1Picco/TV-Dynamic-Audio-Control-System/Schematic_TV-Dynamic-Audio-Control_2026-10-08.png

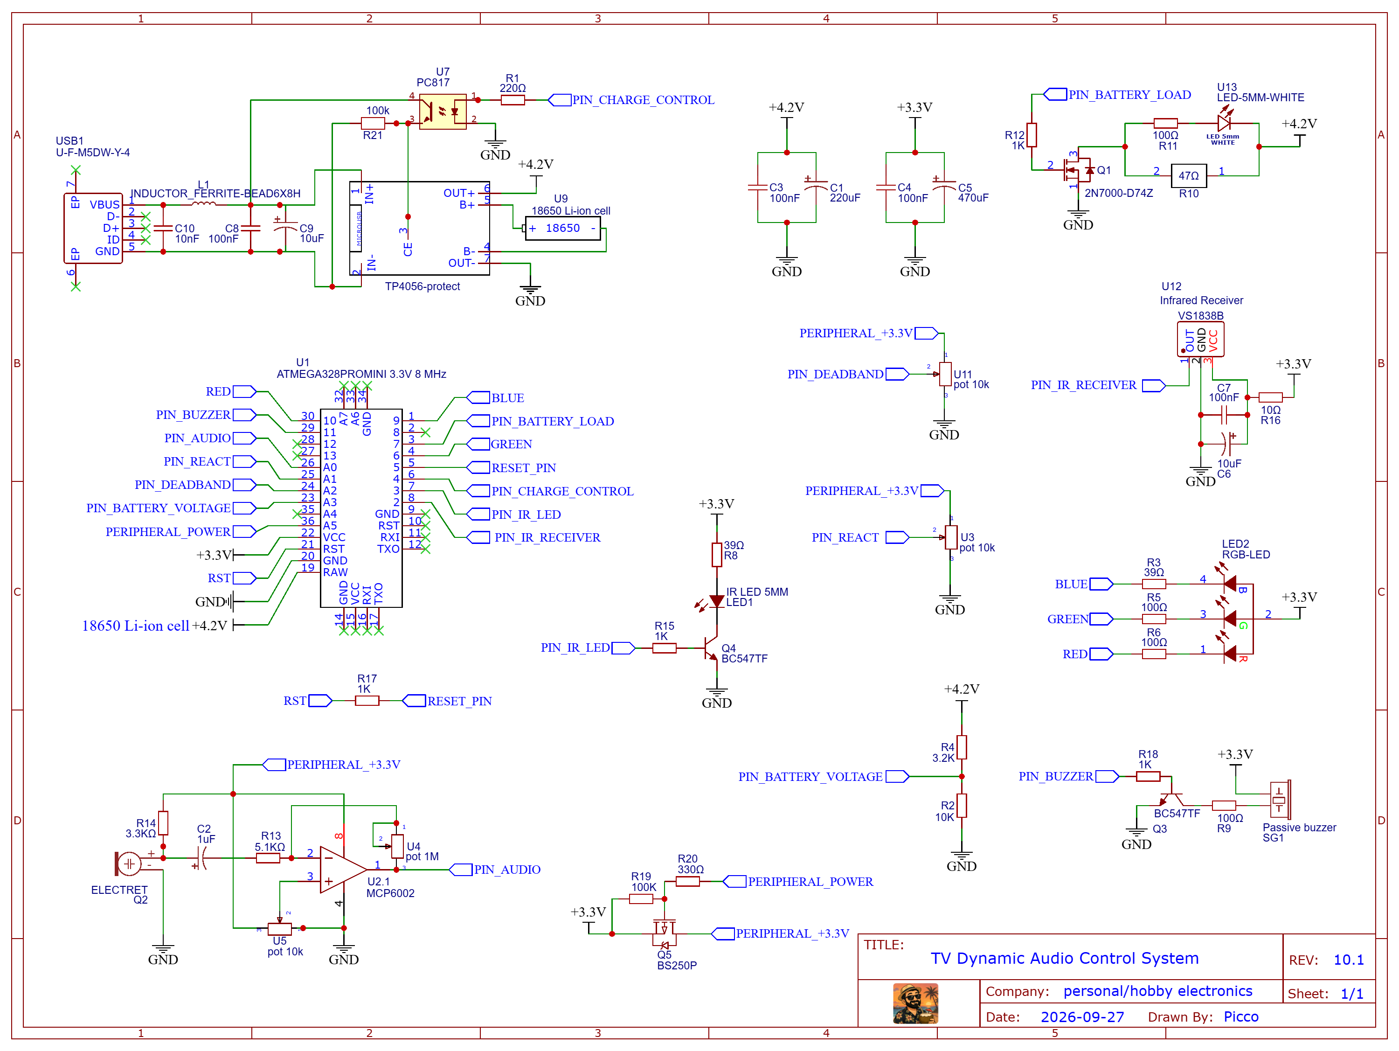
Schematic_TV-Dynamic-Audio-Control_2026-10-08.png
