1Picco/TV-Dynamic-Audio-Control-System/(list of files, drawings)

Other design files:
SCH_TV-Dynamic-Audio-Control_2026-10-04.json
