1Picco/TV-Dynamic-Audio-Control-System/Battery_Management.ino

// ============================================================================
// BATTERY MANAGEMENT FUNCTIONS
// ============================================================================

// VCC MEASUREMENT USING THE INTERNAL 1.1 V BANDGAP REFERENCE
// ============================================================================
// The ADC input is switched to the internal 1.1 V bandgap while AVcc is used
// as the ADC reference. Because ADC = Vbg / Vcc * 1023, the actual supply
// voltage is: Vcc(mV) = Vbg(mV) * 1023 / ADC.
//
// BANDGAP_CONSTANT = Vbg(mV) * 1023.
// Nominal: 1100 * 1023 = 1125300. The real bandgap of each chip can be
// anywhere between ~1.0 V and ~1.2 V. To calibrate, measure your real VCC
// with a multimeter and use: BANDGAP_CONSTANT = measured_VCC_mV * ADC_reading
// (the ADC reading of the bandgap, see the debug print below).

const uint32_t BANDGAP_CONSTANT = 1125600UL;

uint16_t RAW_BANDGAP = 0;   // raw ADC reading of the 1.1 V bandgap
uint16_t RAW_A3 = 0;        // raw ADC reading of the battery divider pin

uint16_t GET_VCC_MV() {

  // AVcc as reference (REFS0), input = internal 1.1 V bandgap (MUX3..MUX1).
  ADMUX = _BV(REFS0) | _BV(MUX3) | _BV(MUX2) | _BV(MUX1);

  // The bandgap needs a short time to stabilize after being selected.
  delay(2);

  // First conversion after changing the mux is discarded.
  ADCSRA |= _BV(ADSC);
  while (bit_is_set(ADCSRA, ADSC))
    ;

  // Real conversion.
  ADCSRA |= _BV(ADSC);
  while (bit_is_set(ADCSRA, ADSC))
    ;
  uint16_t adc = ADC;

  RAW_BANDGAP = adc;   // <-- store the raw reading

  // Protect against division by zero (should never happen).
  if (adc == 0) return 3360;

  return (uint16_t)(BANDGAP_CONSTANT / adc);
}

// ============================================================================
// VERSION 2 - same as GET_BATTERY_VOLTAGE(), but the ADC reference voltage
// is measured instead of using the fixed 3360 mV constant.
// ============================================================================

uint16_t GET_BATTERY_VOLTAGE() {

  // Measure the real VCC right before reading the battery divider,
  // so both readings happen under the same load condition.
  uint32_t vcc_mV = GET_VCC_MV();

  // Discard the first A3 reading after the mux was on the bandgap input
  // (high source impedance divider needs the sample capacitor to settle).
  analogRead(PIN_BATTERY_VOLTAGE);

  RAW_A3 = analogRead(PIN_BATTERY_VOLTAGE);   // <-- store the raw reading

  // ADC reading (0-1023) -> mV at pin A3, using the measured VCC.
  uint32_t raw_mV = ((uint32_t)analogRead(PIN_BATTERY_VOLTAGE) * vcc_mV) / 1023UL;

  // Same divider ratio (3.26K + 10K) / 10K = 1.326 and same offset as V1.
  uint16_t milivolt = (uint32_t)((raw_mV * 13260UL) / 10000UL) + BATTERY_VOLTAGE_OFFSET;
  return milivolt;
}

// ============================================================================

// Read the battery voltage under load and update the global VOLTAGE value.
// A 100 mA load is applied during the measurement to obtain the battery
// voltage under a consistent load condition.

uint16_t READ_BATTERY_VOLTAGE() {

  // Do not perform a battery measurement while charging.
  if (CHARGING_ACTIVE) return VOLTAGE;

  unsigned long CURRENT_MILLIS = millis();

  // Start a new battery measurement when the required interval has elapsed.
  // The first measurement is performed immediately.
  if (!LOAD_TEST_ACTIVE && (FIRST_VOLTAGE_READING_TAKEN || (CURRENT_MILLIS - PREVIOUS_VOLTAGE_READING >= TIME_TO_READ_BATTERY_VOLTAGE))) {

    LOAD_TEST_ACTIVE = true;
    BATTERY_MEASUREMENT_ACTIVE = true;
    VOLTAGE_CAPTURED = false;

    LOAD_TEST_TIMER = CURRENT_MILLIS;

    // Apply the 100 mA battery load and allow the voltage to settle.
    digitalWrite(PIN_BATTERY_LOAD, HIGH);
    // MY_TONE(3000, 15, 1);
    //led.fadeIn(250, 250, 220, 15, 100);
  }

  // Read the battery voltage after 2.95 seconds under load.
  // ===========================================================================

  if (LOAD_TEST_ACTIVE && !VOLTAGE_CAPTURED && (CURRENT_MILLIS - LOAD_TEST_TIMER >= 2950UL)) {

    VOLTAGE_CAPTURED = true;

    // Read the loaded battery voltage and store the result in mV.
    VOLTAGE = GET_BATTERY_VOLTAGE();

    if (!CHARGING_ACTIVE) {
      Serial.print(F("Battery state: "));
      Serial.print(VOLTAGE / 1000);  // whole number
      Serial.print('.');
      Serial.print((VOLTAGE % 1000) / 100);  // tenths
      Serial.print((VOLTAGE % 100) / 10);    // hundredths
      Serial.println(F("V"));
    }
  }

  // Finish the measurement after 3 seconds.
  // The load remains active for an additional 100 ms after the voltage
  // capture, then it is removed.
  // ===========================================================================

  if (LOAD_TEST_ACTIVE && (CURRENT_MILLIS - LOAD_TEST_TIMER >= 3000UL)) {

    // Remove the battery load.
    digitalWrite(PIN_BATTERY_LOAD, LOW);
    // MY_TONE(3000, 10, 1);
    // led.fadeOut(250, 250, 220, 15, 100);

    LOAD_TEST_ACTIVE = false;
    BATTERY_MEASUREMENT_ACTIVE = false;

    // After the initial reading, update the LED feedback using the
    // newly measured battery voltage status.
    if (!CHARGING_ACTIVE && FIRST_VOLTAGE_READING_TAKEN && REMOTE_CONTROL_MODE_ACTIVE) {
      FEEDBACK_LED_ACTIVE = true;
      FEEDBACK_MODE(BATTERY_VOLTAGE_STATUS);
    }

    // Mark this measurement as completed and start the interval timer
    // for the next battery voltage measurement.
    FIRST_VOLTAGE_READING_TAKEN = false;
    PREVIOUS_VOLTAGE_READING = CURRENT_MILLIS;
  }

  return VOLTAGE;
}

// ============================================================================
// BATTERY CHARGING MANAGEMENT
// Monitors battery voltage and controls the charging cycle.
// Charging is periodically paused so the battery voltage can be measured
// without the charger affecting the reading.
// ============================================================================

// ============================================================================
// CHARGING THRESHOLD STORAGE
// Stores both thresholds as one validated, wear-levelled EEPROM record.
// The valid marker is written last so an interrupted write cannot replace
// the previous valid settings.
// ============================================================================

bool VALIDATE_CHARGING_THRESHOLDS(uint16_t startVoltage, uint16_t stopVoltage) {

  return startVoltage >= MIN_START_CHARGING_VOLTAGE &&
         startVoltage <= MAX_START_CHARGING_VOLTAGE &&
         stopVoltage >= MIN_STOP_CHARGING_VOLTAGE &&
         stopVoltage <= MAX_STOP_CHARGING_VOLTAGE &&
         stopVoltage > startVoltage &&
         (uint16_t)(stopVoltage - startVoltage) >= MIN_CHARGING_THRESHOLD_GAP;
}

// Each EEPROM record contains:
// Generation, start low/high, stop low/high, checksum, valid marker.

uint8_t CHARGING_THRESHOLDS_CHECKSUM(
  uint8_t generation,
  uint16_t startVoltage,
  uint16_t stopVoltage) {

  return (uint8_t)(0x5A ^ generation ^
                   lowByte(startVoltage) ^ highByte(startVoltage) ^
                   lowByte(stopVoltage) ^ highByte(stopVoltage));
}

bool READ_CHARGING_THRESHOLDS_SLOT(
  uint8_t slot,
  uint8_t& generation,
  uint16_t& startVoltage,
  uint16_t& stopVoltage) {

  const uint16_t address = EEPROM_CHARGING_THRESHOLDS_BASE +
                           (uint16_t)slot * EEPROM_CHARGING_THRESHOLDS_SLOT_SIZE;

  if (EEPROM.read(address + 6) != 0xA5) return false;

  generation = EEPROM.read(address);
  startVoltage = (uint16_t)EEPROM.read(address + 1) |
                 ((uint16_t)EEPROM.read(address + 2) << 8);
  stopVoltage = (uint16_t)EEPROM.read(address + 3) |
                ((uint16_t)EEPROM.read(address + 4) << 8);

  if (EEPROM.read(address + 5) !=
      CHARGING_THRESHOLDS_CHECKSUM(generation, startVoltage, stopVoltage)) return false;

  return VALIDATE_CHARGING_THRESHOLDS(startVoltage, stopVoltage);
}

int8_t FIND_NEWEST_CHARGING_THRESHOLDS_SLOT(uint8_t& newestGeneration) {

  int8_t newestSlot = -1;
  newestGeneration = 0;

  for (uint8_t slot = 0; slot < EEPROM_CHARGING_THRESHOLDS_SLOT_COUNT; slot++) {

    uint8_t generation;
    uint16_t startVoltage, stopVoltage;

    if (!READ_CHARGING_THRESHOLDS_SLOT(slot, generation, startVoltage, stopVoltage)) continue;

    if (newestSlot < 0 || (int8_t)(generation - newestGeneration) > 0) {
      newestSlot = slot;
      newestGeneration = generation;
    }
  }

  return newestSlot;
}

// Restore the newest valid charging thresholds from EEPROM.
// Defaults remain active if no valid record has been stored yet.

void RESTORE_CHARGING_THRESHOLDS() {

  uint8_t generation;
  int8_t newestSlot = FIND_NEWEST_CHARGING_THRESHOLDS_SLOT(generation);

  if (newestSlot < 0) return;

  READ_CHARGING_THRESHOLDS_SLOT(
    newestSlot, generation, START_CHARGING_VOLTAGE, STOP_CHARGING_VOLTAGE);
}

// Save a new pair of thresholds without disturbing the previous valid record.

bool STORE_CHARGING_THRESHOLDS(uint16_t startVoltage, uint16_t stopVoltage) {

  if (!VALIDATE_CHARGING_THRESHOLDS(startVoltage, stopVoltage)) return false;

  uint8_t newestGeneration;
  int8_t newestSlot = FIND_NEWEST_CHARGING_THRESHOLDS_SLOT(newestGeneration);

  if (newestSlot >= 0) {
    uint16_t storedStart, storedStop;
    uint8_t generation;

    if (READ_CHARGING_THRESHOLDS_SLOT(newestSlot, generation, storedStart, storedStop) &&
        storedStart == startVoltage && storedStop == stopVoltage) return true;
  }

  uint8_t targetSlot = newestSlot < 0 ? 0 :
                      (uint8_t)((newestSlot + 1) % EEPROM_CHARGING_THRESHOLDS_SLOT_COUNT);
  uint8_t nextGeneration = newestSlot < 0 ? 0 : (uint8_t)(newestGeneration + 1);

  const uint16_t address = EEPROM_CHARGING_THRESHOLDS_BASE +
                           (uint16_t)targetSlot * EEPROM_CHARGING_THRESHOLDS_SLOT_SIZE;

  // Invalidate the selected slot before writing its new data.
  EEPROM.update(address + 6, 0x00);

  EEPROM.update(address, nextGeneration);
  EEPROM.update(address + 1, lowByte(startVoltage));
  EEPROM.update(address + 2, highByte(startVoltage));
  EEPROM.update(address + 3, lowByte(stopVoltage));
  EEPROM.update(address + 4, highByte(stopVoltage));
  EEPROM.update(address + 5,
                CHARGING_THRESHOLDS_CHECKSUM(nextGeneration, startVoltage, stopVoltage));

  // Write the valid marker last. The previous record remains valid until this point.
  EEPROM.update(address + 6, 0xA5);

  uint8_t verifyGeneration;
  uint16_t verifyStart, verifyStop;
  int8_t verifySlot = FIND_NEWEST_CHARGING_THRESHOLDS_SLOT(verifyGeneration);

  return verifySlot == targetSlot &&
         READ_CHARGING_THRESHOLDS_SLOT(verifySlot, verifyGeneration, verifyStart, verifyStop) &&
         verifyStart == startVoltage && verifyStop == stopVoltage;
}

// ============================================================================

void BATTERY_CHARGE_CHECK() {
  unsigned long CURRENT_MILLIS = millis();

  // Update the battery voltage when a scheduled measurement is available.
  VOLTAGE = READ_BATTERY_VOLTAGE();

  // Wait until an active battery measurement has finished.
  if (BATTERY_MEASUREMENT_ACTIVE) {
    return;
  }

  // Start charging when the battery has dropped to the configured
  // start voltage and the previous charging cycle is complete.
  if (CHARGING_CYCLE_COMPLETE) {
    if (VOLTAGE <= START_CHARGING_VOLTAGE && !LOW_VOLTAGE_START_CHARGING) {
      digitalWrite(PIN_CHARGE_CONTROL, HIGH);
      eepromWearLevelWrite(EEPROM_CHARGING_ACTIVE_BASE, true);
      info.println(F("Low voltage! Charging started."));
      //led.flash(0, 255, 0, 30, 0, 1);

      LOW_VOLTAGE_START_CHARGING = true;
      CHARGING_CYCLE_COMPLETE = false;
      CHARGING_ACTIVE = true;
    }
  }

  // Periodically pause charging so the battery voltage can be checked.
  // The charger is disabled before measuring to avoid measuring the
  // charging voltage instead of the actual battery voltage.
  if (CURRENT_MILLIS - LAST_TIME_VOLTAGE_READING >= TIME_TO_CHECK_BATTERY_CHARGE_STATE && !CHARGING_PAUSED && LOW_VOLTAGE_START_CHARGING) {

    digitalWrite(PIN_CHARGE_CONTROL, LOW);

    MY_TONE(3300, +350, 20, 2);

    // White indicates that charging is temporarily paused
    // for a battery voltage measurement.
    //led.fadeIn(220, 220, 200, 15, 150);

    info.println(F("Charging PAUSED to measure battery voltage."));

    CHARGING_PAUSED = true;
    PAUSE_CHARGING_TO_READ_VOLTAGE = CURRENT_MILLIS;
  }

  // After charging has been paused long enough for the battery voltage
  // to stabilize, measure the battery voltage again.
  if (CHARGING_PAUSED && CURRENT_MILLIS - PAUSE_CHARGING_TO_READ_VOLTAGE >= WAITE_FOR_VOLTAGE_STABILIZATION) {

    VOLTAGE_DURING_PAUSED_CHARGING = GET_BATTERY_VOLTAGE();

    // White fade out indicates that battery voltage measurement was done.
    //led.fadeOut(220, 220, 200, 15, 150);

    info.print(F("Stabilized battery voltage: "));
    info.print(VOLTAGE_DURING_PAUSED_CHARGING / 1000);
    info.print('.');
    info.print((VOLTAGE_DURING_PAUSED_CHARGING % 1000) / 100);
    info.print((VOLTAGE_DURING_PAUSED_CHARGING % 100) / 10);
    info.println(F("V"));

    // If the stabilized battery voltage has reached the configured
    // charging limit, finish the charging cycle.
    if (VOLTAGE_DURING_PAUSED_CHARGING >= STOP_CHARGING_VOLTAGE) {

      digitalWrite(PIN_CHARGE_CONTROL, LOW);
      eepromWearLevelWrite(EEPROM_CHARGING_ACTIVE_BASE, false);
      info.println(F("Charging complete."));

      MY_TONE(4000, -235, 20, 3);

      CHARGING_ACTIVE = false;
      CHARGING_CYCLE_COMPLETE = true;
      LOW_VOLTAGE_START_CHARGING = false;

      // If the battery has not reached the charging limit, resume charging.
    } else if (VOLTAGE_DURING_PAUSED_CHARGING < STOP_CHARGING_VOLTAGE && LOW_VOLTAGE_START_CHARGING) {

      digitalWrite(PIN_CHARGE_CONTROL, HIGH);
      info.println(F("Resume charging."));

      MY_TONE(4000, 20, 2);
    }

    // Finish the charging pause and start the timer for the next
    // periodic charging-state check.
    CHARGING_PAUSED = false;
    LAST_TIME_VOLTAGE_READING = CURRENT_MILLIS;
  }
}
// ============================================================================
// Function to display battery VOLTAGE using RGB LED patterns.
// Uses the appropriate voltage value depending on whether the battery
// is currently charging, then displays the voltage digit by digit.
// ============================================================================

void VERIFY_BATTERY_VOLTAGE() {

  // While charging, use the stabilized voltage measured during the
  // charging pause. Otherwise, perform a normal battery voltage reading.
  if (CHARGING_ACTIVE) {
    VOLTAGE = VOLTAGE_DURING_PAUSED_CHARGING;
  } else {
    VOLTAGE = READ_BATTERY_VOLTAGE();
  }

  // Convert the voltage from mV to hundredths of a volt.
  // Example: 3450 mV -> 345 -> 3.45 V
  const byte wholeNumber = VOLTAGE / 1000;
  const byte tenths = (VOLTAGE / 100) % 10;
  const byte hundredths = (VOLTAGE / 10) % 10;

  // Display the three voltage digits using the corresponding LED colors.
  BLINK_BATTERY_VOLTAGE(wholeNumber, tenths, hundredths);
}

// ============================================================================
// Blink one voltage digit using the specified RGB color.
// The complete blink pattern is finished before the function returns.
// ============================================================================

void BLINK_DIGIT(byte count, byte red, byte green, byte blue, uint16_t pauseAfter) {

  // A zero digit is represented by no blinks, followed by the requested pause.
  if (count == 0) {
    if (pauseAfter > 0) delay(pauseAfter);
    return;
  }

  // Timing of one complete blink cycle.
  static const uint16_t fadeIn = 200;
  static const uint16_t onTime = 100;
  static const uint16_t fadeOut = 350;
  static const uint16_t offTime = 200;

  unsigned long singleCycleDuration = (unsigned long)fadeIn + onTime + fadeOut + offTime;
  unsigned long totalAnimationTime = singleCycleDuration * count;

  FEEDBACK_PATTERN_RESTART = true;  // <-- the one line to add here

  unsigned long startTime = millis();

  while (millis() - startTime < totalAnimationTime) {
    FEEDBACK_PATTERN(0, red, 0, green, 0, blue, count,
                     fadeIn, onTime, fadeOut, offTime, false, 0);
    delay(5);
  }

  led.setColor(0, 0, 0);

  if (pauseAfter > 0) {
    delay(pauseAfter);
  }
}

// ============================================================================
// Display the battery VOLTAGE as a sequence of colored LED blinks.
//
// Whole volts     = green
// Tenths          = yellow
// Hundredths      = red
//
// A white sequence marks the beginning and end of the voltage display.
// ============================================================================

void BLINK_BATTERY_VOLTAGE(byte wholeNumber, byte tenths, byte hundredths) {

  // Start indication: white LED sequence for 2 seconds.
  unsigned long startSeqDuration = SECONDS(2);
  unsigned long startSeqBegin = millis();

  FEEDBACK_PATTERN_RESTART = true;

  while (millis() - startSeqBegin < startSeqDuration) {
    FEEDBACK_PATTERN(0, 220, 0, 220, 0, 200,
                     1, 150, 300, 250, 0, false, 0);
  }

  // Whole volts: green.
  BLINK_DIGIT(wholeNumber, 0, 220, 0, SECONDS(1));

  // Tenths: yellow.
  BLINK_DIGIT(tenths, 220, 100, 0, SECONDS(1));

  // Hundredths: red.
  BLINK_DIGIT(hundredths, 220, 0, 0, SECONDS(1));

  // End indication: two short white flashes.
  led.flash(220, 220, 200, 30, 50, 2);

  // Reset the feedback timers after the voltage display sequence has completed.
  RESET_FEEDBACK_TIMERS();
}
