1Picco/TV-Dynamic-Audio-Control-System/(commit log)

2026-09-26 Refactor battery management functions and comments
    Refactor battery management functions to improve readability and maintainability. Update comments for clarity and ensure consistent voltage measurement under load.
2026-09-27 Feedback color changes
    Updated the yellow fade LED feedback during the volume reduction warning state to incorporate DEADBAND_COUNTER. Instead of a fixed yellow fade, the pattern now dynamically shifts color tinting and fade transitions based on whether the deadband is positive, negative, or neutral.
    [Automatic_Audio_Control.ino]
2026-10-04 Refactor battery management functions for clarity
2026-10-04 Updated and enhance RGB LED feedback functions
    Updated the FEEDBACK_PATTERN and related functions to provide RGB LED feedback based on system status and battery voltage.
2026-10-04 Enhance sleep management with peripheral power control
    Updated sleep management functions to include peripheral power control during sleep and wake cycles.
2026-10-04 Add peripheral power control and mute feature
    Updated TV audio control system to include new peripheral power control and mute functionality.
2026-10-24 Enhance battery voltage measurement with calibration
    Updated battery management functions to include calibration correction for voltage readings and improved comments for clarity.
2026-10-30 Refactor battery management functions and logic
    Refactor battery management functions to improve readability and maintainability. Adjust voltage measurement logic and LED feedback for better performance.
2026-10-30 Refactor LED feedback pattern and logic
    Refactor feedback pattern functions and improve LED color feedback logic based on battery voltage.
2026-10-30 Refactor sleep management and IR handling
    Updated sleep management functions to improve power saving and IR command handling.
2026-10-30 Feedback time depending on battery voltage.
2026-11-01 Updated LED FADE() function
    Added an optional audioLowered parameter to select between two independent fade timing configurations.
    Default timing remains unchanged for deadband feedback.
    Added a faster timing pattern for audio lowered warnings while the system waits for silence before restoring the volume.
    Reused the existing FEEDBACK_PATTERN() implementation without duplicating code.
2026-11-09 Refactor TV audio control code and add power off feature
    Added delayed auto power off functionality.
2026-11-09 Refactor REMOTE_CONTROL_MODE for better IR handling
    Updated the REMOTE_CONTROL_MODE function to improve handling of IR remote commands, including adjustments to LED feedback and charging control.
2026-11-09 Refactor LED feedback functions for battery status
2026-11-09 Improved VCC measurement and update voltage functions
    Added VCC measurement using internal 1.1V bandgap reference and updated GET_BATTERY_VOLTAGE function to use measured VCC. Modified BLINK_DIGIT and BLINK_BATTERY_VOLTAGE functions to include feedback pattern restart.
2026-11-12 Refactor battery management functions for accuracy
    Updated BANDGAP_CONSTANT and added raw ADC readings for bandgap and battery voltage.
2026-11-12 Refactor LED feedback functions for clarity
2026-11-12 Update print statement from 'Hello' to 'Goodbye'
2026-11-12 Modify connection instructions for Arduino
    Updated instructions for connecting to Arduino with variable baud rate.
2026-11-12 Add configurable battery charging thresholds
2026-11-12 Harden battery threshold validation
2026-11-12 Refactor battery management functions
    Refactor battery management functions to improve readability and maintainability. Consolidate voltage measurement logic and update LED feedback methods.
2026-11-12 Restore EEPROM settings and charging thresholds
    Restored charging thresholds and settings from EEPROM during setup.
